ice3x2/Wifi_Humidifier/image/photo2.JPG

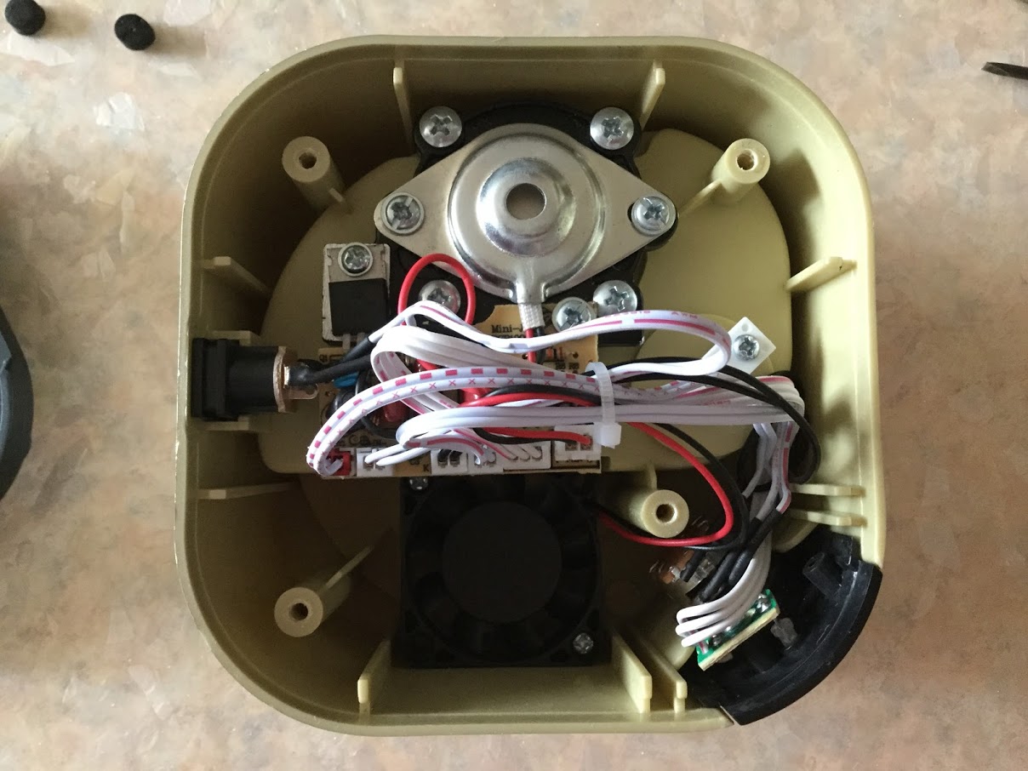
image/photo2.JPG
