ice3x2/Wifi_Humidifier/(threads)

Thread 1 (2015-09-04):

Arduino::Setup mode 진입. [1h-]

ice3x2, 2015-09-04:
* 해야할 일
  * 버전, 접속하려는 AP 의 ssid(char[32]), pass(char[32]) 와 서버 주소(char[54]), 그리고 현재 모드를 입력한 구조체 Config 를 만든다.
     * SETUP 모드와 BOOT 모드를 정의하고 임의의 값을 넣어준다.
     * 구조체 Config 내에 있는 현재 모드 값에는 기본적으로 BOOT 값을 넣어준다.
  * eeprom 에 데이터가 온전하게 있다면 위 구조체 Config 값을 읽어와서 넣어준다.
  * 리셋 버튼을 5초 이상 누를 경우 상태 변수에 setup 모드가 들어가며 LED 를 500ms 간격으로 점멸하도록 만든다.
  * setup 모드 진입과 동시에 다음과 같은 명령어를 순서대로 호출한다.
    * Config->mode 에 SETUP 을 넣어 eeprom 에 기록.
    * AT+RST  리셋, 이후 2초 대기
    * AT+CWMODE=2 AP 모드 진입, 이후 1초 대기.
    *  AT+CIPMUX=1 다중 커넥션 유지, 이후 1초 대기.
    * AT+CIPSERVER=1,80 서버모드 설정, 이후 1초 대기.

ice3x2, 2015-09-04:
* 이슈 내용 수정.
   * AT+RST 이외에 나머지 명령어들을 호출할 때, 1초씩 대기를 하지 않고 반환 값 OK 를 기다린다.

ice3x2, 2015-09-04:
* 이슈 해결 완료 : 아직 코드는 commit 하지 않음. ㅎㅎ

ice3x2, 2015-09-04:
* 추가
  * 푸쉬버튼 고장남. 다시 만들어야 한다.
  * Confg save/load 가 제대로 동작하지 않는 것 같다. 이것도 다시 만들어야 한다.

ice3x2, 2015-09-05:
* 이슈 해결 완료
   * 스위치 아날로그 0번 자리로 옮김. SoftwareSerial 과 DigitalInput 을 동시에 사용하면 문제 생기는데, 특정 포트 그룹에 대하여 문제가 생긴다. 이에 대한 것은 이번 프로젝트를 종료한 뒤에 자세히 조사.
  * 저장, 불러오기 관련 문제 해결. Config 구조체 변수를 동적 생성에서 정적으로 바꿈.

Closed 2015-09-05.

Thread 2 (2015-09-04):

Arduino::Setup page html 코드. [1h -]

ice3x2, 2015-09-04:
* **해야할 일**
  * Setup page
    * AP 의 SSID 와 패스워드 입력하는 칸을 만든다.
    * 컨트롤 서버 주소를 입력하는 칸을 만든다.
    * 확인 버튼을 만든다.
      * 확인 버튼을 누를 때, get 으로 설정 값을 보낸다.
  * 'SSID 또는 패스워드 값이 잘못 되었습니다.' 또는 '서버 값이 잘못 되었습니다' 라는 메세지를 띄워주는 페이지나 설정이 완료 되었습니다. 리셋 버튼을 눌러주세요.' 와 같은 메세지를 띄워주는 페이지 코딩.
    * 글자는 대문짝만하게...

* **하면 안 되는 일**
  * 아직 무선 AP 의 리스트를 출력하는 짓거리는 하지 않는다.
  * Admin 페이지에 CSS 를 넣어서 이쁘게 꾸미지 않는다.
  * 가능하면 자바 스크립트는 최소화 한다.

ice3x2, 2015-09-06:
* 1509062049 : Ah... CSS 포기 하려니깐 심란하다.

ice3x2, 2015-09-06:
* 1509071203 : 보류... 메모리 부족.
  * ATmega328 의 2kbyte 메모리에서 웹서버를 돌린다는 것은 무리였다.

ice3x2, 2015-09-07:
* 1509071150 모든 기능이 완성된 뒤에 디버깅용 로그 코드 다 지우고 남는 메모리 확인하여 재개하도록 한다.

Closed 2015-09-23.

Thread 3 (2015-09-04):

Arduino::Setup mode 에서 값 설정 api 구현 [1h +]

ice3x2, 2015-09-04:
* 해야할 일
   * Setup mode 에서 'http://주소/set/[ssid값]/[ssid 패스워드]/[컨트롤 서버 주소]'  를 받았을 때 각 위치의 값들을 파싱하여 Config 구조체에 넣는다.
   * 입력 받은 값을 통하여 무선 AP 에 넣는다.
     * 성공하면 성공 페이지 전송 뒤에 Config.mode 값을 boot 로 바꿔준 뒤에 eeprom 에 저장한 다음 아무것도 안 한다. 점멸되던 LED는 완전 소등한다.
     * 실패하면 실패 페이지 전송.

* 하지 말아야 할 일
  * 잘못된 값에 의한 에러 처리는 하지 말아야 한다.

ice3x2, 2015-09-04:
* 작업1. 우선 HTTP 프로토콜을 파싱해야 한다. (난감..)

ice3x2, 2015-09-05:
* Link 와 Unlink 상태 값 가져오기 추가 완료.

ice3x2, 2015-09-06:
* 작업2 완료.
   * 데이터 패킷 형식을 조금 수정함.   /set::[ssid값]::[ssid 패스워드]::[컨트롤 서버 주소] 으로 변경.

ice3x2, 2015-09-06:
* 작업3 완료. 만약 AP 주소와 password 값이 잘못 되어있을 경우 에러 페이지 출력.

Closed 2015-09-06.

Thread 10 (2015-09-06):

Node::프로젝트 생성 [최우선 순위!]

ice3x2, 2015-09-06:
#### 해야할 일
  * Node 프로젝트를 생성한다.
  * 프로젝트 생성할 때  express 를 붙여버린다.
  * lodash 나 node-persist , gulp, RxJS 등을 추가하고, 개발 환경을 구성한다.

#### 아직 하면 안 되는 일
  * 이번 milestone이 끝날때 까지 express 와 tcp 의 연동은 꿈도꾸지 않는다...

ice3x2, 2015-09-06:
* Node 별로인데.. 쩝..

ice3x2, 2015-09-07:
* node-persist  사용은 좀 오바였음, 간단한데 구림.
* simple-node-db 를 사용. 간단하고 네이티브 기반이고 빠름.
  * 2.2mb 크기로 분할된 바이너리 파일로 저장된다.
  *  key 지원 및 간단한 검색 쿼리 지원.  현재의 프로젝트에서 시간을 key 값으로 데이터를 넣기 때문에 검색 속도가 나쁘지 않음.
  * 1천만건의 데이터를 넣는 것으로 테스트.

Closed 2015-09-07.

Thread 11 (2015-09-06):

Node,Arduino::가습기 제어 구현 [1d+]

ice3x2, 2015-09-06:
#### 선행 이슈
  * #7 , #8

#### 해야할 일
  * 서버에 접속된 가습기로 패킷을 보내어 제어할 수 있도록 한다.
  * 최소 동작 습도, 최대 습도, 최소 동작 온도를 가습기로 보낸다.
  * 현재 온도, 습도 값을 임의로 설정한 다음 테스트 한다.

ice3x2, 2015-09-09:
* 이슈 #17 을 통하여 완료.

Closed 2015-09-09.

Thread 13 (2015-09-06):

Node,Arduino::서버 접속 구현 [최우선 순위!]

ice3x2, 2015-09-06:
#### 선행 이슈
  *  #7

#### 해야할 일
  * 가습기가 동작모드에서 첫 전원이 들어올 때, 서버에 접속하도록 한다.
  * 서버에 접속하면서 온라인에 저장되어 있던 모든 설정값을 가져와 적용 하도록 해야 하는데, 이는 다른 이슈를 해결하면서 점진적으로 구현하도록 한다. 추가 작업은 코멘트로 정리한다.

ice3x2, 2015-09-09:
* 이슈 #17 을 통하여 완료.

Closed 2015-09-09.

Thread 14 (2015-09-06):

Node, Arduino :: 가습기로부터 온도와 습도 데이터 가져오기. [1d-]

ice3x2, 2015-09-06:
#### 선행 이슈
  * #6 #12

#### 해야할 일
  * 가습기로부터 온도와 습도 정보를 서버로 읽어와 DB 에 저장한다.

#### 하지 말아야할 일
  * 아직 DB 를 검색하거나 인덱싱 하거나 하지 않는다. 그냥... 저장만 한다.
  * DB 는 그냥 node-persist 와 같이 따로 설치할 필요 없는 라이브러리 형태의 간단한 녀석을 사용한다.

ice3x2, 2015-09-09:
* 이슈 #17 을 통하여 완료.

Closed 2015-09-09.

Thread 15 (2015-09-06):

Arduino :: 코드 정리하기. [틈틈이]

ice3x2, 2015-09-06:
#### 해야할 일
  * 본인 혼자 쓰는거라 코드를 개 난장판으로 대충대충 짰지만, 그래도 많은 사람들이 보는 Github 에 (별로 안 보겠지만..) 올리는 거라 다른 사람들이 보고 쉽게 이해 하려면 조금이라도 정리해야 한다.
  * 틈틈이 정리하여 코멘트로 올린다.

#### 절대 하면 안 되는일
  * 너무 오바해서 리팩토링 하거나 반복되는 함수 몇 개를 클래스로 빼거나 하지 말자.. 시간 아깝다.

ice3x2, 2015-09-23:
* 리팩토링 완료.

Closed 2015-09-23.

Thread 4 (2015-09-06):

Arduino:ESP8266 AT 명령어 Response 값 체크하는 클래스 [1+]

ice3x2, 2015-09-06:
* *해야할 일*
 * Response 값
    * OK : \r\nOK
    * ERROR : \r\nERROR
    * no change : no change\r \n
    * Link : Link\r\n
    * Unlink : \r\nUnlink
  * 가능하면 메모리를 최대한 절약해 보도록 한다.

* *아직 하면 안 되는 일*
   * AT 명령어를 직접적으로 처리하는 과정 까지는 안 해도 된다.

ice3x2, 2015-09-06:
* 워낙 간단해서 테스트 코드는 따로 올리지 않음.

Closed 2015-09-06.

Thread 6 (2015-09-06):

Node::TCP 통신 포맷 구상 [1d +]

ice3x2, 2015-09-06:
#### 해야할 일
  * 포맷 구상
    * 테스트 접속.
    * Heart beat .
    * 최저 동작 습도, 최고 습도 설정.
    * 주기적으로 받아오는 온도,습도 정보.
    * 현재 동작 상태 가져오기.
    * 기본 설정값(ap ssid,ap password,server address, server port) 가져오기.
    * 가능하면 팬 속도, 분무량 제어에 대한 값을 설정하고 가져오기.
 * 통신 방법 (Timeout 등) 에 대하여 구상.
 * 하단 코멘트로 정리한다.

#### 하지 말아야할 일
  * 어차피 본인만 쓰려고 만드는 것이니 너무 오바해서 처리하지 않는다.
  * 동시에 기기 여러대 이상 접속에 대한 것을 처리하지 않는다. (물론 한대만 접속 하도록 강제할 수 있다.)

ice3x2, 2015-09-06:
* '최저 동작 습도, 최고 습도 설정.'  에 몇 도 이하에서 동작하는 것에 대한 설정을 넣어야 한다.

ice3x2, 2015-09-07:
* 형식
       * 하트 비트 :  'h::'
       * 메세지 : 'm::[메세지 타입 a-z]::[메세지]
       * 에러 : 'e::[에러 코드]'
       * ACK 메세지로 'OK' 를 보낸다.
   * 각 데이터 타입
      *  최저 동작 온/습도, 최고 습도, 팬 속도, 분무량
         * 서버 ---> 가습기
         *  'm::a::[최저 온도(float)]::[최저 습도(float)]::[최고 습도(float)]::[팬속도 (0-255)]::[분무량 (0-255)]'
      * 주기적으로 받아오는 온도,습도 정보.
         * 가습기 ---> 서버
         *  'm::t::[온도(float)]::[습도(float)]'
     * 현재 동작 상태 가져오기.
        1. 서버 ---> 가습기
            *  'm::g'
        2. 가습기 ---> 서버
            * (가습기로부터 OK 가 가장 먼저 날라온다.)
            *  'm::a::[최저 온도(float)]::[최저 습도(float)]::[최고 습도(float)]::[팬속도 (0-255)]::[분무량 (0-255)]'

ice3x2, 2015-09-07:
* 최초 접속시 서버에서 가습기로 이전에 저장된 동작 명령을 전송한다. 가습기에서는 이 것을 받아서 서버에 접속 되어있는지를 확인한다.
* 30초 간격으로 가습기에서 서버로 heart beat 와 임의의 수를 보낸다. 그럼 서버에서 이 것을 되돌려 줘야 하는데, 2초 이내로 에코 메세지가 오지 않는다면 연결이 끊어진 것으로 간주하고 가습기의 아두이노는 에러 상태로 전환한다.

ice3x2, 2015-09-09:
* 문제1.  (이 것때문에 의욕없이 퍼져있었음.)
  * 9600bps 에서 buffer overflow 문제가 발생할 수 있다. 덕분에 http 요청시 response 가 발생할 때, 처음에는 데이터가 술술 잘 들어오지만 시간이 갈수록 엉망이 된다.
  * node.js net 모듈 코드상에서 socket 에 'on' 이벤트가 발생할 때, 바로 write 를 날려주면 원인지 무엇인지 몰라도 esp8266 은 데이터를 반환하지 않는다. 약 1초 이상 딜레이를 줘야 반환 하는데 이 것도 버퍼 오버플로우 문제와 연관 되어 있는지는 모르겠다.
* 솔루션
  * 원인을 알아내기에는 시간이 오래 걸리고(해외 포럼에도 비슷한 문제를 겪고 있는 사람들이 있다.) 그렇다고 다른 MCU 모듈을 이용하여 추가 버퍼를 구현하기에는 시간이 오래 걸린다. --> 가장 이상적인 해결책은 비용적으로 큰 리스크를 갖고 있다.
  * 그냥... connect 동작에서는 ok response 를 3초 뒤에 날리고 가습기에서 날리는 데이터는 response 를 받지 않도록 한다. 서버에서 날리는 컨트롤 데이터는 ack 가 반드시 이루어져야 하지만 못 받을 가능성이 아주 크기 때문에 제대로 받을 때 까지 500ms 간격으로 줘낸 날린다... ㅎㅎㅎ

ice3x2, 2015-09-09:
* 프로토콜 재정의
  * 헤더
     * 헤더 사이즈는 총 2byte.
     * '[명령어 타입  a-z]:'
   * 각 데이터 타입
      *  동작 명령 : 최저 동작 온/습도, 최고 습도, 팬 속도, 분무량
         * 서버 ---> 가습기
         *  'c:[최저 온도(2byte)][최저 습도(2byte)][최고 습도(2byte)][팬속도 (1byte)][분무량 (1byte)]'
             * 총 8byte.
             * 분무량이 0일 경우 동작하지 않는 것과 같다.
             * 온도와 습도는 원래 float 타입으로 처리되나, 통신할 때는 10 을 곱하고 2byte(int16_t) 로 변환하여 처리한다.
            * 클라이언트에서는 이 메세지를 받으면 'r:' 을 서버로 돌려줘야 한다. 서버에서는 동작 명령 데이터를 클라이언트에 보냈는데도 불구하고 1.5초동안 응답이 없으면, 동작 명령을 재전송한다.
      * 주기적으로 받아오는 온도,습도 정보.
         * 가습기 ---> 서버
         *  'm:[온도(2byte)][습도(2byte)]'
            * 6byte
            * 5초에 한 번씩 서버로 날린다.
            * 만약 서버에서 15초동안 이 데이터를 받아오지 못한다면 가습기와 연결이 끊어진 것으로 간주한다.
      * 물 상태 이벤트
         * 가습기 ---> 서버
         *  'm:[물 있음?(1byte)]'
           * 3byte
           *  물이 있을 경우 1, 없을 경우 0. 상태가 바뀔때만 서버로 전송.
      * 최초 접속, 또는 테스트.
          * 가습기 ---> 서버 (접속)
          * k:[ 8 글자 이내의 key 값 (8byte)] (테스트 접속은 k: 대신 t: 를 사용한다.)
          * key 값이 일치할 경우 접속이 성공한 것이며, 동작 명령을 클라이언트로 보내서 활성화.
          * key 값이 일치하지 않을 경우 'e:' 를 보내고 연결을 종료한다.

ice3x2, 2015-09-09:
* 적용 완료.

Closed 2015-09-09.

Thread 7 (2015-09-06):

Node,Arduino::Test 접속 구현. [1d -]

ice3x2, 2015-09-06:
### 선행 이슈
  * #6, #10

### 해야할 일
  * 가습기가 서버에 잘 붙는지를 확인하기 위한 Test 접속을 구현한다.
  * 추가로 Setup 모드에서 서버 주소를 설정할 경우 이를 테스트 하여 문제가 있을 경우 에러메세지를 출력하는 것을 구현한다.
  * 서버에 key 값을 설정하여 고유의 기기만 접속할 수 있도록 만들어 본다.
  * Test 관련 데이터가 확인되면 연결을 종료한다.

### 하지 말아야할 일
  * 딱히...

ice3x2, 2015-09-09:
* 이슈 취소 -> 테스트 접속을 아두이노에서 따로 처리하기엔 메모리, 프로세스 비용이 소비된다. 이슈 #17 을 처리하면서 경험상 최대한 자원을 아껴야 한다는 것을 알았음.

Closed 2015-09-09.

Thread 8 (2015-09-06):

Arduino::가습기 제어. [1h -]

ice3x2, 2015-09-06:
#### 선행 이슈
  * #12

#### 해야할 일
  * 특정 온도 이하, 그리고 최저 습도 이하에서 최고 습도에 도달할 때 까지 가습기를 동작하도록 만든다.
  * 팬, 분무량 PWM 제어를 구현한다. 하지만, 구현만하고 사용하지 않는다. (PWM 제어가 되는 팬으로 교체해야 하며, 분무량을 담당하는 진동자 모듈의 하드웨어적인 PWM 제어는 아직 검증되지 않음.)
  * 테스트를 위해서 직접 환경을 만들어 줄 수 없으므로 시리얼 통신으로 테스트 해보고 문제 없으면 테스트 코드를 삭제한다.

#### 하지 말아야할 일
  * 오프라인 상태에서 가습기가 동작하도록 EEPROM 에 데이터를 저장하지 말아야 한다. 나의 아두이노의 EEPROM 은 소중하니깐... (EEPROM 은 최대 쓰기 10만번 까지 가능하지만 사용할수록 성능이 저하된다.)

ice3x2, 2015-09-09:
* 이슈 #17 을 통하여 완료.

Closed 2015-09-09.

Thread 9 (2015-09-06):

Hardware::진동자 모듈에 연결된 전원 스위치에 연결된 케이블을 제거, 파워 케이블에 스위치 연결. [7d]

ice3x2, 2015-09-06:
### 해야할 일
  * 진동자 모듈에서부터 전원 스위치로 연결되는 케이블을 제거하고 서로 연결해 버리고 잘 말아서 수축튜브로 마무리 한다.
  * 아답터로 연결되는 파워 케이블을 전원 스위치로 연결하기 전에 그라운드 쪽으로 연결하는 것이 안전한지, 아니면 + 쪽으로 연결하는 것이 안전한지에 대하여 주변 전자공학 박사님께... 물어보고 진행한다.

### 하지 말아야할 일
  * 제발좀 태워먹지 말자...

ice3x2, 2015-09-06:
* 주변 전자 공학과 나온 지인들을 귀찮게 해야돼서 시간이 오래 걸림.

ice3x2, 2015-09-15:
* 이슈 보류 : 온/습도 모니터링을 위해서 가습기 동작과 관계 없이 항상 켜놓도록 한다. 다만, 전원 LED 로 흐르는 전압을 읽어서 전원 상태를 확인할 수 있도록 해야한다.

Closed 2015-09-15.

Thread 16 (2015-09-07):

Arduino:Setup mode api 에서 port 설정을 제거하고 그 자리에 key 값을 넣을 수 있도록 한다. [최우선순위!]

ice3x2, 2015-09-07:
#### 해야할 일
  * 기존에 이슈 #3 에서 해결된 Setup mode 의 api 는 http://192.168.4.1/set/[ssid]::[password]::[server addr]::[server port] 로 구성되어 있다. server port 를 제거하고 이 것을 최대 8자리의 문자열로 구성된 key 값으로 바꾼다.
  * port 번호는 하드코딩 하고 (#define PORT 으로 정의) key 값을 Config 구조체 변수에 넣어서 저장하도록 한다.

Closed 2015-09-08.

Thread 17 (2015-09-08):

Arduino, Node: Control 모듈 구현 [최우선순위!]

ice3x2, 2015-09-08:
#### 선행이슈
  * #6

#### 해야할 일
  * 우선 가습기 제어에 관하여 생성한 이슈를 모두 닫고 이 이슈로 통합한다.
  * XCode 를 통하여 Control 클래스를 만들고 Node 의 Control 모듈과 통신 테스트 하며 개발한다.
  * 이슈 #6 에서 정의한 통신 포맷에 맞춰서 데이터를 주고 받을 수 있도록 한다.
  * 세부 작업에 대한 사항은 코멘트로 진행한다.

#### 아직 하지 말아야할 일
  * ESP8266 컨트롤 라이브러리를 개발하지 않는다.
  * ESP8266 으로부터 데이터를 읽어서 처리하는 모듈을 개발하지 않는다.

ice3x2, 2015-09-08:
* 최초 접속 관연된 동작 구현 완료.
* 작업1. 주기적으로 클라이언트 Control 모듈에서 서버로 온도와 습도 전달.

ice3x2, 2015-09-08:
* 작업 1완료.
* 작업 2. Control 모듈에서 물 상태값을 읽어서 서버로 전달.

ice3x2, 2015-09-08:
* 작업2 완료.
* 작업3. 서버에서 Control 모듈 클라이언트로 동작 제어 데이터(컨트롤 데이터) 보냄.

ice3x2, 2015-09-09:
##### 201509101256

*  아.. 시바.. 문제 발생. 자세한 내용은  이슈 #6  항목 코멘트 참고.
* 작업4. 이슈 #6  코멘트로 새로 정의한 데이터 포맷에 맞춰서 개발.

ice3x2, 2015-09-09:
#####201509100122

* 작업4. 마무리, 아두이노의 Control 모듈에서 Fan 과 Power 의 pwm 을 제어하는 이벤트를 발생한다.
  * 현재 습도가 minHumidity 보다 작을 때, 가동 시작하여 maxHumidity 에 도달하면 가동 중지.

ice3x2, 2015-09-09:
* 이슈 완료.

Closed 2015-09-09.

Thread 18 (2015-09-09):

Arduino, Server :: 쌩 TCP 연결에서 HTTP 프로토콜로 변경. (ㅠㅠ) [1d+]

ice3x2, 2015-09-09:
### 해야할 일
  * TCP 서버와 HTTP 서버를 분리하니 서버 복잡성이 상당히 커진다.
  * TCP 서버 코드를 전부 제거하고 HTTP 를 통하여 데이터를 받아온다.
  * 모든 데이터를 : 으로 구분된 배열로 주고 받는다.
  * 형식
    * Request
       * http://주소/ctrl/[key]:[온도]:[습도]:[물 있을 경우1, 없을 경우 0]
       * 온도와 습도는 실수로 받아온 값에서 10을 곱하여 처리.
    * Response
       * 키가 일치할 경우
          * 1:[최소 습도]:[최대 습도]:[최대 불쾌지수]:[power pwm]:[fan pwm]
       * 키가 일치하지 않을 경우
          * 0:0:0:0:0:0

ice3x2, 2015-09-12:
* 이슈 해결 완료.
  * ESP8266 의 결함으로 인하여 시간이 오래 걸렸다. 이 것에 대한 자세한 설명은 #20  에 기술하였다.
  * 데이터 형식도 다음과 같이 수정하였다.
    * Request
      * http://주소/data?key=[키]&t=[온도]&h=[습도]&w=[물 있을 경우1, 없을 경우 0]
    * Response
      * 키가 일치할 경우
        * *[최소 습도]*[최대 습도]*[최대 불쾌지수]*[power pwm]*[fan pwm]*****
     * 키가 일치하지 않을 경우
        * *-1*-1*-1*-1*-1*****

Closed 2015-09-12.

Thread 19 (2015-09-10):

ESP8266 HTTP Get 라이브러리 개발. [1+]

ice3x2, 2015-09-10:
### 해야할 일
  * 그렇게 피하고 싶었던 시간이 왔다. 공개된 ESP8266 라이브러리는 너무 구려서(이 프로젝트에 사용하기도 적합하지 않고 수정해서 사용하자니 시간이 오래 걸려서.) 직접 만든다.
  * 일단 이 프로젝트에서만 사용하는 모드들만 설정할 수 있도록 만든다.
  * 소프트웨어 시리얼을 사용할 수 있도록 만든다.
  * 데이터 읽고 쓰기를 구현한다.

ice3x2, 2015-09-10:
##### 1509110234

  * 구현해야 할 API
    * 리셋.
    * STA, AP, SP_STA 모드 구현.

ice3x2, 2015-09-23:
* 해결 완료.

Closed 2015-09-23.

Thread 20 (2015-09-12):

현재까지 상황 정리 - ESP8266 모듈에서 TCP, HTTP 통신할 때, busy s... 뜨는 문제 해결. [완료]

ice3x2, 2015-09-12:
*  ESP8266 모듈과 0.922 펌웨어에 결함이 있는 것을 발견. 이 결함은 다음과 같다.
    * single 모드에서 발생.  multi 모드에서는 테스트 해보지 않음.
    * TCP 데이터를 보냄.
    * 간혹 SEND OK (데이터 보내기 성공했을 때의 반환 값) 가 반환되지 않고 이 상태에서 다른 명령을 주면 busy s... 가 뜬다.
 * 이 문제에 대한 논란은 해외 포럼에서도 어렵지 않게 찾아볼 수 있으며, 소프트웨어 시리얼 9600bps 의 속도로 통신할 경우 발생한다고 한다. 아직 115200bps 로 통신하지 않아서 확인은 못 하였다.
 * 데이터를 받아올 때도, 9600bps 에서 종종 버퍼오버플로우가 발생한다.
 * 이 때문에 connect 속성(헤더)을  close 로 줘서 http 로 날려봤다. 이번에는 다른 문제가 발생한다. 내용은 아래와 같다.
   * GET 으로 요청을 하고 받아올 때, 서버에서 1000s 이상 딜레이를 주지 않는다면 버퍼 오버플로우가 발생. 결국 깨진 데이터가 들어온다. 물론 딜레이는 길면 길수록 좋다.
   * connect 속성을 close 로 했기 때문에 response 값을 받아온 이후 바로 커넥션이 종료 되어야 하지만, 종료 메세지가(UNLINK) 가 반환이 안 되는 경우가 있다. 되게 골치아픈 문제인데... 하루종일 삽질하다가, 커넥션 종료가 안 될경우 AT+RST 명령어를 통하여 바로 리셋해 버리도록 했다.
   * 리셋 이후에도 좀 골때리는 현상이 발견되는데, ip 주소를 확인해 보면 할당받지 않는 것으로 뜨지만 어쨌든 공유기와 연결되어 있다. 만약 연결이 실패할 경우 공유기와 연결을 확인하여 재접속 하는 프로세스를 넣어야 한다.

ice3x2, 2015-09-12:
* 헤외 포럼에서, 펌웨어 최신 버전인 0.95 에서도 같은 문제가 있다고 한다. 어떤 분은 NPN 트랜지스터를 전원에 연결해서 문제 있을 경우 강제 리셋 시켜버리도록 했다고 한다. 이렇게 까지 한 이유는 esp-8266 모듈의 eeprom 보호를 위하여... d  나는 쓰다가 eeprom 망가지면 그냥 새로 하나 사서 교체할 것이다. 어차피 모듈의 eeprom 망가지는데 3년 이상 걸릴 것 같고, wifi 모듈 가격도 5천원 미만.
* 클라이언트 모드에서는 서버에 연결된 상태에서 임의로 연결을 종료할 수 없다. 종료 명령을 날리는 순간 모듈이 리셋되고 먹통된다.
* 많은 문제가 해결된 정식 버전 펌웨어가 나오면 그동안의 삽질이 물거품이 되어 허무하겠지만, 그래도 빨리 나왔으면  좋겠다. 원래 5일로 잡았던 프로젝트가 1주일 이상으로 길어지고 있다.

ice3x2, 2015-09-12:
* 그 밖에, node 의 express 엔진에서는 http 프로토콜 형식에 문제가 있으면 칼같이 접속을 끊어버린다. 아예 헤더를 읽을 수 없는 중대한 문제라면 당연한 것이지만, GET 방식으로 요청할 때 body 에 데이터를 넣는다던지 커스텀 헤더에 허용되지 않는 문자를 넣어도 마찬가지다. (구글이나 네이버는 서버는 잘 받아 먹는디.. )

ice3x2, 2015-09-13:
* AT+RST 를 날리고 서버에 바로 연결하면 아직 초기화가 덜 되었는지, no ip 에러를 발생시킨다. 이 때, IP 주소를 확인하고 0.0.0.0 일 경우 ap 에 다시 접속하도록 설정하였다.
* 8시간 연속 테스트중. 간혹 문제가 발견될 때마다 수정하였지만, 최근 3시간동안 큰 문제 없이 잘 동작하고 있다. 서버를 끄고 켜도 문제 없이 동작.

Closed 2015-09-13.

Thread 21 (2015-09-13):

Server::DB 에 가습기 센서로부터 읽어온 값과 컨트롤 값을 저장. [2+]

ice3x2, 2015-09-13:
#### 해야할 일
  * 가습기에서 보내준 온도, 습도, 물 상태 값을 1분 단위로 평균을 내어 DB에 저장한다.
  * 물/파워 상태와 파워PWM, 팬 PWM 값도 1분 단위로 평균을 내어 저장한다.
  * key 값은 각 시간의 millisecond 를 나타내는 정수 값을 문자열로 변환하여 저장한다. 이 때, 문자의 길이를 꼭 13자로 맞춘다. 그 이하일 경우 앞에 0을 붙인다.
  * millisecond 를 입력 받아 각 시간, 일, 월, 년 단위로 평균을 구하여 가져오는 함수를 구현한다.
  * simple-node-db  를 이용하여 DB 사용을 간소화 한다.

ice3x2, 2015-09-13:
* 간단한 동작이므로 딱히 테스트 코드는 작성하지 않음. (13일 일요일에 하루종일 뒹굴고 영화보고 놀면서 데이터 수집, 저장 테스트 하였음.)
* 해결 완료.

Closed 2015-09-13.

Thread 22 (2015-09-13):

Server::현재 온도, 습도 그리고 불쾌지수, 물/전원 상태, 연결 상태 값을 가져오는 rest api 구현. [1h+]

ice3x2, 2015-09-13:
#### 해야할 일.
  * 서버로부터 현재 온도와 습도, 그리고 불쾌지수, 물/전원 상태, 연결 상태 값을 가져오는 rest api 를 구현한다.
  * 이 api 는 10초에 한 번씩 호출될 수 있다.
  * json 타입을 반환한다.

ice3x2, 2015-09-13:
* 만약 1분 내로 최신 데이터가 없다면 연결이 끊어진 것으로 간주한다.

ice3x2, 2015-09-13:
* 해결 완료.

ice3x2, 2015-09-13:
##### 데이터 및 상태 값 가져오기
  * Request
    * post/all : /status
  * Response
    * temperature : 온도
    * humidity : 습도
    * warter : 물/상태. -1 -> 전원 꺼짐, 0 -> 물 없음, 1 -> 정상
    * discomfort : 불쾌지수
    * time : 갱신 시간(ms)
    * connection : 서버와 가습기간의 연결 상태. 0 -> 연결 끊김, 1 -> 상태 안 좋음, 2 ->  보통, 3 -> 상태 좋음

##### 제어 값 가져오기
  * Request
    * post/all : /ctrl
  * Response
    * minHumidity : 최소 동작 습도
    * maxHumidity : 최대 동작 습도
    * thresholdDiscomfort : 동작 제한 불쾌지수
    * powerPWM : 전원 PWM
    * fanPWM : 팬 PWM

Closed 2015-09-13.

Thread 23 (2015-09-13):

Server::그래프에 표시될 온,습도 전원PWM, FAN PWM 상태와 시간등을 리스트로 가져오는 api 구현 [1d -]

ice3x2, 2015-09-13:
#### 해야할 일
  * 기준 시간을 입력 받아 각 시간, 일, 월, 년 단위로 평균화한 데이터를 리스트로 받아온다.
  * 시간 단위 : 최대 60 개, 일 단위 : 최대 24개, 월 단위 : 최대 31개, 년 단위 : 최대 12개 받아올 수 있다.

ice3x2, 2015-09-13:
* 이슈 해결 완료.

ice3x2, 2015-09-13:
* Request (post 방식만 지원)
  * /list
    * type : h -> 시간 단위, d -> 날짜 단위, m -> 월 단위, y -> 년 단위로 데이터 리스트를 가져오도록 설정. 만약 잘못된 값을 넣을 경우 빈 배열 반환.
    * time : 시간 (milliseconds)

Closed 2015-09-13.

Thread 24 (2015-09-14):

Web::온도, 습도, 불쾌지수, 동작상태, 연결상태 를 보여주는 박스를 만든다.

ice3x2, 2015-09-14:
#### 해야할 일
  * 우선 각 상태의 값의 크기에 따라서 배경 색을 다르게 보여주는 박스 뷰를 Angular.js 의 디렉티브로 만든다.
  * 연결이 끊겼을 경우 박스 위에 not connected. 메세지를 보여줄 수 있도록 한다.
  * 서버로부터 값을 가져와서 각 값들을 이쁘게... 뿌려준다.

ice3x2, 2015-09-14:
* 해결 완료.

Closed 2015-09-14.

Thread 25 (2015-09-14):

Web,Server::웹 페이지로 컨트롤 구현[2d+]

ice3x2, 2015-09-14:
##### 해야할 일
  * 웹 페이지에 현재 동작 상태, 동작 습도 설정 값, 파워 PWM, 팬 PWM 상태를 출력한다.
  * 인증/인증 해제 기능
    * 자물쇠 모양 아이콘 버튼을 만든다.
    * 기본은 자물쇠가 잠겨있는 모양이며, 이 때 아이콘을 클릭하면 인증 키 값을 입력할 수 있는 다이얼로그 창이 뜬다.
    * 인증 키 값을 올바르게 입력하면 (서버에서 인증 과정을 거친후에) 잠겨있는 자물쇠 모양의 아이콘이 풀려있는 모양으로 바뀐다.
   * 자물쇠가 풀려있는 상태에서, 동작 습도 설정값, 파워 PWM, 팬 PWM 상태 박스를 클릭하면 이 것을 설정할 수 있는 다이얼로그 창이 출력된다.
  * 설정 기능
    * 동작 습도 설정 값을 나타내는 박스를 클릭하면 최소 습도, 최대 습도값을 설정할 수 있는 다이얼로그창이 출력된다.
    * 파워 PWM 과 팬 PWM 을 선택하면 동시에 각 PWM 값을 설정할 수 있는 다이얼로그창이 출력된다.

ice3x2, 2015-09-14:
* 인증 구현 완료.

Closed 2015-09-18.

Thread 27 (2015-09-16):

Web::그래프 그리기 [1d+]

ice3x2, 2015-09-16:
### 해야할 일
  * 드디어 올 것이 왔다. 년, 월, 날짜별 데이터를 그래프로 그려준다.
  * 코멘트로 진행사항 작성.

ice3x2, 2015-09-16:
* 그래프 라이브러리는 C3 와 이를 wrapping 한 angular-chart 사용.

ice3x2, 2015-09-16:
##### 작업.1
  * 그래프에 출력하기 전 데이터 정규화 작업.
  * 로딩 프로그래스 띄우기.
  * 데이터 레퍼런스 지정하는 라디오 박스 값 변경 때 마다 해당되지 않는 날짜 셀렉터 disable 시키기.

ice3x2, 2015-09-16:
*  'angular-chart' 차트 라이브러리 C3 옵션들을 사용할 수 있도록 수정.
   * 설치 : bower install https://github.com/ice3x2/angular-chart.git#e4593eabd9b84732d179efd001c49169e096a216

ice3x2, 2015-09-16:
* 그래프 출력 완료. 모바일에서도 잘 보이도록 하였다.

ice3x2, 2015-09-17:
* 우와... 진짜 Angular material 도 막 쓰니깐 엄~~~~청 느린데, C3 까지 붙이고 나니깐 거의 못 쓸 지경이다.

ice3x2, 2015-09-17:
* 로딩 프로그래스 귀찮아서 안 만듦. 생각해보니 내가 쓰려고 만드는데 필요 없음. 이슈 종료.

Closed 2015-09-17.

Thread 28 (2015-09-18):

Arduino : ESP8266 reponse check 모듈 개선. [1h+]

ice3x2, 2015-09-18:
#### 해야할 일
  * ESP8266 reponse check 모듈은 AT 명령어에 대한 총 8가지 반환 값(1byte)을 처리할 수있지만 사용해 보니 8개 이상의 반환값들이 존재한다.
  * 명령어에 대한 반환 값 총 32개(32비트)를 처리할 수 있도록 만든다.

ice3x2, 2015-09-18:
* 이거 잘 만들면 다른 UART 하드웨어 모듈에도 적용할 수 있음.

Closed 2015-09-23.

Thread 30 (2015-09-19):

Arduino,Server :: 서버와 아두이노 간의 세션 유지.

ice3x2, 2015-09-19:
### 해야할 일
  * 아두이노에서 서버 최초 접속시에 세션 키를 가져올 수 있도록 한다.
  * 첫 번째로 서버에서 아두이노로 랜덤하게 생성된 공개 키를 보내주고 그 키를 이용하여 간단한 해쉬로 만들어 항상 아두이노의 버퍼 내에 저장한다.
  * 데이터 전송시 SID 라는 헤더를 만들고 이 것엔 해쉬 키를 넣어서 반환한다.
  * 서버에서는 아두이노로 받은 SID 헤더를 이용하여 세션 체크.

ice3x2, 2015-09-23:
* 이슈 보류.
  * Atmega328 공간 부족

Closed 2015-09-23.

Thread 31 (2015-09-23):

Server, Arduino :가습기 컨트롤을 전적으로 서버에서 하도록 한다. [1h+]

ice3x2, 2015-09-23:
### 해야할 일
  * 가습기에서 서버로 데이터를 보내고 컨트롤 값들을 받아올 때, 단지 파워와 팬 pwm 값만 받아올 수 있도록 한다.
  * 모든 컨트롤 값들은 서버에서 전적으로 처리한다.
  * 가습기 최초 시작시 pwm 값을 최대치로 준다. 이렇게 한다면 서버와 연결되지 않은 상황에서도 기존의 방식대로 사용할 수 있기 때문이다.

ice3x2, 2015-09-23:
* 해결 완료.
  * 이제, 세부적인 컨트롤을 서버에서 처리하도록 할 수 있음.

Closed 2015-09-23.
