ice3x2/Wifi_Humidifier/(commit log)

2015-09-05 * 첫 커밋
2015-09-05 * Link 와 Unlink 상태 값 가져오기 추가 완료.
2015-09-05 EEPROM 에 Config 를 저장하는 코드를 좀 더 직관적으로 바꿈.
2015-09-06 * issue #4 : ESP8266 의 AT 명령어 Response 값 체크하는 클래스 생성.
    [Arduino.ino, ESPResponseChecker.cpp, ESPResponseChecker.h]
2015-09-06 * issue #3 해결 완료.
    [Arduino.ino, ESPResponseChecker.cpp, ESPResponseChecker.h]
2015-09-06 * 150906 마무리
2015-09-07 * issue #10, Node 프로젝트 생성
2015-09-07 * issue #16 해결 완료.
    [Arduino.ino]
2015-09-08 * Control 서버 구현중
2015-09-08 * 임시 xcode test project 추가.
2015-09-08 * issue #17 -> 주기적으로 온습도 값을 읽어서 서버에 전송하는 코드 구현.
2015-09-08 issue #17 -> 주기적으로 물 상태 값을 읽어서 서버에 전송하는 코드 구현.
2015-09-09 * issue #17 처리중.
    [Arduino.ino]
2015-09-09 issue #17 : Arduino, Node: Control 모듈 구현
    [Arduino.ino]
2015-09-12 * issue #20 busy s... 뜨는 문제 해결.
    [Arduino.ino, ESPResponseChecker.cpp, ESPResponseChecker.h]
2015-09-13 * issue #21 해결. 가습기 센서로부터 읽은 값 DB 에 저장. * ESP8266 모듈에서 리셋 명령어 사용 후에 IP를 확인하고, 연결이 끊어졌을 경우 재접속 하는 코드 구현
    [Arduino.ino]
2015-09-13 * issue #22 해결 완료.
2015-09-13 * issue #23 해결. DB 로 부터 값 가져오는 api 구현.
2015-09-14 * issue #24 해결. 웹페이지를 통하여 온도, 습도, 불쾌지수 보여주도록 구현. 아직 동작상태는 보여주지 않음.
2015-09-14 * issue #25 처리중 -> web,server 인증 구현 완료.
    [Arduino.ino]
2015-09-15 * issue #25 해결중 -> 로그아웃 구현 완료. routes 코드 정리 및 세분화
2015-09-15 * issue #25 web 페이지로 설정값 제어할 수 있도록 구현 완료.
2015-09-16 * 디자인 쌈박하게 변경. * issue #27 처리중 -> 그래프 출력까지 완료.
2015-09-16 * 불필요한 파일 정리
2015-09-16 * status-nomarlizer 구현중, 하지만, 사파리에서 문제 발생.
2015-09-16 * issue #27 해결중.
2015-09-16 * 쓸데없는 파일 정리
2015-09-17 * issue #27 해결 완료
    [Arduino.ino]
2015-09-17 * 웹 페이지 완성.
2015-09-17 * PWM 제어 주파수 변경 테스트 완료
2015-09-18 누더기 아두이노 코드 정리 마일스톤 진행하기 전 준비와 커밋.
2015-09-19 * issue #29 : power 필드 최대치가 100이 아닌 255로 잡혀있는 문제 해결
2015-09-22 * 아두이노 코드 정리중.
2015-09-23 * issue #19 : ESPTTP 라이브러리 개발. * 아두이노 코드 정리 * 모바일 페이지에서 설정 버튼 클릭 안 되는 현상 수정. * issue #28 AT+COMMAND response 값을 위한 check 모듈 개선
    [Arduino.ino, ESPResponseChecker.cpp, ESPResponseChecker.h, ESPTTP.cpp, ESPTTP.h]
2015-09-23 * 누락된 패키지 추가
2015-09-23 * properties 파일을 통하여 database 의 경로를 설정할 수 있도록 수정.
2015-09-23 * 설명 이미지 추가
2015-09-23 * 사진 업데이트
2015-09-23 * issue #31 : 가습기 PWM 컨트롤 값을 전적으로 서버에서 계산하도록 처리하였다.
    [Arduino.ino]
2015-09-23 * 대기상태에서 설정값을 변경하였을 때, 현재 온/습도 상태가 동작 범위안에 들어간다면 동작하도록 수정.
2015-09-23 * 회로 이미지 업데이트
2015-09-25 * issue #32 해결
2015-09-25 * 시작시 DB LOCK 파일을 제거하여 DB 손실을 막는다.
